balazsradak/Ventilator/manufacturing/blower/CAD/tubing_adapter_gasket.dxf

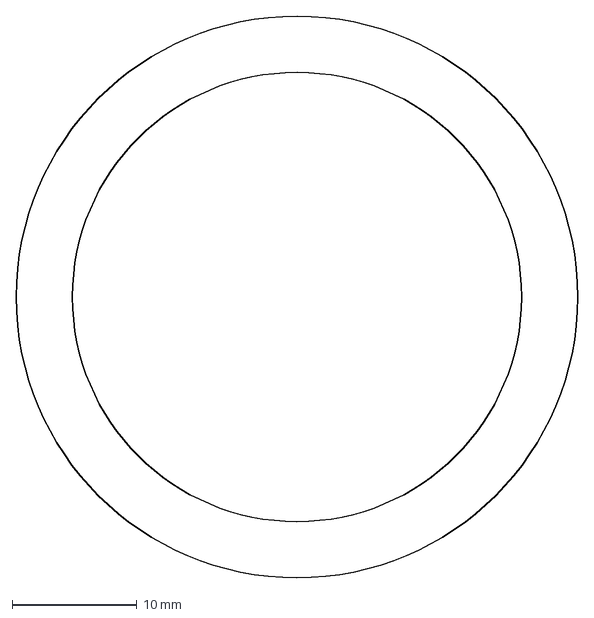
[picture p1: CAD file, 2020-12-17]
manufacturing/blower/CAD/tubing_adapter_gasket.dxf
45.0 x 45.0 mm
