balazsradak/Ventilator/manufacturing/blower/CAD/driver_mounting_plate.dxf

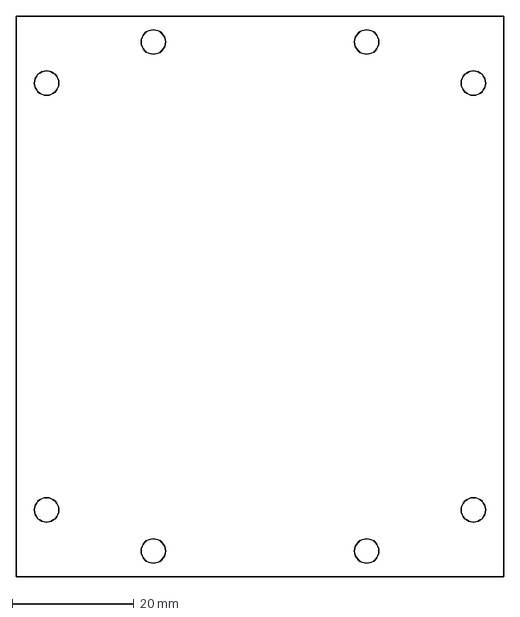
[picture p2: CAD file, 2020-12-15]
manufacturing/blower/CAD/driver_mounting_plate.dxf
80.0 x 92.0 mm
