balazsradak/Ventilator/manufacturing/blower/CAD/blower_holding_plate.dxf

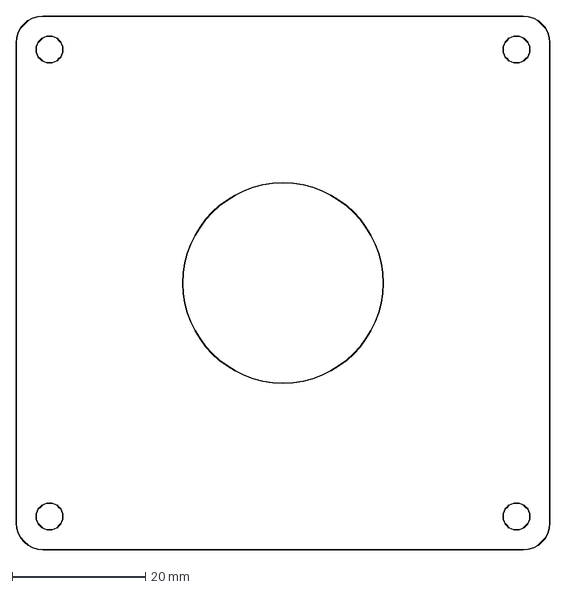
[picture p3: CAD file, 2020-12-15]
manufacturing/blower/CAD/blower_holding_plate.dxf
80.0 x 80.0 mm
