balazsradak/Ventilator/manufacturing/filter_holder/assets/Upper_Acrylic_Face_Plate_ebk v1.dxf

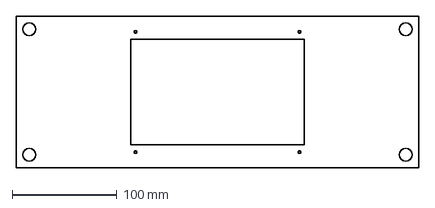
[picture p4: CAD file, 2020-12-18]
manufacturing/filter_holder/assets/Upper_Acrylic_Face_Plate_ebk v1.dxf
385.0 x 145.0 mm
