balazsradak/Ventilator/(list of files, cad)

Other CAD files:
manufacturing/blower/assets/Blower_Driver_Mounting.dxf
manufacturing/filter_holder/assets/Lower_Acrylic_Face_Plate.stl
manufacturing/blower/assets/Blower_gasket1.dxf
manufacturing/filter_holder/assets/Upper_Acrylic_Face_Plate.stl
manufacturing/blower/assets/Blower_Holding_plate.dxf
manufacturing/blower/assets/Blower_gasket2.dxf
manufacturing/blower/assets/Blower_adapter_holding_plate.dxf
manufacturing/blower/CAD/Blower Assembly.iam
manufacturing/blower/CAD/Dummy Pnuematics Tray.ipt
manufacturing/blower/CAD/WS7040-12-X200N [Blower] v1.ipt
manufacturing/blower/CAD/blower_gasket.ipt
manufacturing/blower/CAD/blower_holding_plate.idw
manufacturing/blower/CAD/blower_holding_plate.ipt
manufacturing/blower/CAD/driver_mounting_plate.idw
manufacturing/blower/CAD/driver_mounting_plate.ipt
manufacturing/blower/CAD/tubing_adapter.idw
manufacturing/blower/CAD/tubing_adapter.ipt
manufacturing/blower/CAD/tubing_adapter_gasket.ipt
manufacturing/blower/CAD/tubing_adapter_holding_plate.idw
manufacturing/blower/CAD/tubing_adapter_holding_plate.ipt
manufacturing/filter_holder/assets/Lower_Acrylic_Face_Plate.dxf
manufacturing/filter_holder/assets/Lower_Acrylic_Face_Plate.idw
manufacturing/filter_holder/assets/Lower_Acrylic_Face_Plate.ipt
manufacturing/filter_holder/assets/Upper_Acrylic_Face_Plate.dxf
manufacturing/filter_holder/assets/Upper_Acrylic_Face_Plate.idw
manufacturing/filter_holder/assets/Upper_Acrylic_Face_Plate.ipt
