balazsradak/Ventilator/manufacturing/blower/README.md

# Blower Sub-assembly



The blower/fan provides air pressure to the ventilator's pneumatic circuit. Currently this is only responsible for
delivery of ambient air, independent of the question of oxygen supply. In a full system that includes oxygen supply,
the blower is a subsystem to the overarching gas delivery control system.

Characterization tests for the blower are [here](characterization-tests).

## Basic assembly

This entails the bare essentials for a functional testing setup, such as a [pizza build](../pizza_build).
The pneumatic aspect of the blower assembly includes the blower and a short segment of tubing compatible with blower
outlet diameter. The electrical aspect of the blower assembly encompasses the driver board and wires to interface
with the [PCB](../../pcb).

### Parts

**Note: If you are a member of the RespiraWorks team, review the [part purchasing guidelines][ppg]
BEFORE purchasing any parts.**

[ppg]: ../../manufacturing/purchasing_guidelines.md

| Item | Quantity | Manufacturer  | Part # | Price (USD)  | Sources[*][ppg] | Notes |
| ---- |---:| --- | --- | ---:|:---:|---|
|**A1**| 1 | | WS7040-12-X200N | 65.00 | [A][a1ali] | 12v blower and driver. Make sure to choose with driver when ordering. |
|**A2**| 1 | | WS1208 | 24.00 | [W][a2won] | **optional** blower driver, in case blower above did not come with driver. |
|**A3**| ~50 mm | McMaster-Carr | 5234K57 | 21.50 / 5ft  | [C][a3mcmc] | Soft latex tubing, 5/8" ID, 7/8" OD |
|**A4**| 2 | McMaster-Carr | 9579K72 | 12.21 / 20 | [C][a4mcmc] | Herbie clip J (20.3-23mm) for clamping 7/8"OD tubing |
|**A5**| 2 or 4 | JST | SVH-21T-P1.1 | 0.11 | [K][a5digi] [R][a5rs] | VH crimps, for power connector |
|**A6**| 1 or 2 | TE | 1-1123722-2 | 0.18 | [K][a6digi] [R][a6rs] | VH housing 2 pin, for power connector |

[a1ali]:  https://www.aliexpress.com/item/32980201709.html
[a2won]:  https://wonsmart-motor.en.made-in-china.com/product/hsjxFewOppVg/China-Air-Pump12V-Brushless-Motor-12V-Blower-Fan-Driver.html
[a3mcmc]: https://www.mcmaster.com/5234K57
[a4mcmc]: https://www.mcmaster.com/9579K72
[a5digi]: https://www.digikey.com/short/z44fjr
[a5rs]:   https://export.rsdelivers.com/product/jst/svh-41t-p11/jst-nv-vh-female-crimp-terminal-contact-16awg-svh/7620692
[a6digi]: https://www.digikey.com/short/z44fwj
[a6rs]:   https://export.rsdelivers.com/product/jst/vhr-2n/jst-vhr-female-connector-housing-396mm-pitch-2/8201172

**Please note:** Quantities of items a5+a6 depend on whether you intend to integrate the blower into an enclosed
ventilator assembly as [described below](#enclosed-assembly).

### Tools

| Item | Quantity | Manufacturer  | Part # | Price (USD) | Sources[*][ppg] | Notes |
| ---- |---:| --- | --- | ---:|:---:| ----- |
|**B1**| 1 | Preciva | PR-3254 (PR102001)  | 39.99 | [Z][b1amzn] | Crimping tool for HX and HV connectors |

[b1amzn]:https://www.amazon.com/gp/product/B07R1H3Z8X

**Note: Items a5, a6 and b1 above are duplicated in the [wiring BOM](../../design/electrical-system/wiring.md)**

### Instructions for basic assembly

Attach a short segment of tubing (**A3**) to blower (**A1**) outlet.

Use Herbie clip (**A4**) to secure tubing to blower outlet. Alternatively, you can use a zip-tie.

You will also have to crimp connectors (**A5 + A6**) to the second end of the wiring (using **B1**) that connects the
driver board to the [PCB](../../pcb).

A basic assembly is pictured at the top of this page.

**Please note:** the picture above includes an optional tubing reducer that is specified on the [pizza build](../pizza_build) page.

## Enclosed assembly

The basic assembly needs further modifications to be mounted into an [enclosed ventilator assembly](../enclosed_build).
The pneumatic interface includes gaskets and adapter for tubing that runs to the filtered air inlet on the front panel.
The mechanical aspect of this assembly includes all hold-down and mounting plates for the blower and blower
driver board, and for the above pneumatic interface components. Electrically, the enclosed assembly also requires longer
wiring.

### Parts 2

| Item  | Quantity | Manufacturer  | Part # | Price (USD) | Sources[*][ppg] | Notes |
| ----- |---:| --- | --- | ---:|:---:|---|
|**C1** | 1 | RespiraWorks  | tubing_adapter | 1 (material) | [B][c1rw] | 3D printed from data in link |
|**C2** | ~200cm²  | McMaster-Carr | 8560K357 | 54.68 / 3716cm²  | [C][c2mcmc] | 1/4" (~6mm) thick clear acrylic sheet, to make **C3-C5** below |
|**C3** | 1 | RespiraWorks  | driver_mounting_plate | ~1.1 (material)  | [B][c3rw] | Driver mounting plate cut from acrylic (**C2**) using drawing in link, uses ~75 cm² |
|**C4** | 1 | RespiraWorks  | blower_holding_plate | ~0.9 (material)  | [B][c4rw] | Blower holding plate cut from acrylic (**C2**) using drawing in link, uses ~60 cm² |
|**C5** | 1 | RespiraWorks  | tubing_adapter_holding_plate | ~0.9 (material)  | [B][c5rw] | Tubing adapter holding plate cut from acrylic (**C2**) using drawing in link, uses ~60 cm² |
|**C6** | ~80cm² | McMaster-Carr | 1370N13-1370N131 | 6.75 / 232cm² | [C][c6mcmc] | 1/16" durometer 30 neoprene gasket material, to make items **C7** and **C8** below |
|**C7** | 1 | RespiraWorks  | blower_gasket | ~1.2 (material)  | [B][c7rw] | Blower gasket cut from (**C6**) using drawing in link, uses ~40 cm² |
|**C8** | 1 | RespiraWorks  | tubing_adapter_gasket | ~1.2 (material)  | [B][c8rw] | Tubing adapter Gasket cut from (**C6**) using drawing in link, uses ~40 cm² |
|**C9** | 8 | McMaster-Carr | 93625A150 | 6.04 / 100 | [C][c9mcmc] | M4 nylon insert lock nuts |
|**C10**| 16 | McMaster-Carr | 93475A230 | 1.86 / 100 | [C][c10mcmc] | M4 washers |
|**C11**| 4 | McMaster-Carr | 92000A224 | 9.60 / 100 | [C][c11mcmc] | M4 x 14mm Philips head screws, for blower driver |
|**C12**| 4 | McMaster-Carr | 91290A574 | 15.45 / 10 | [C][c12mcmc] | M4 x 85 mm hex head screws |
|**C13**| 4 | McMaster-Carr | 93657A079 | 1.21 | [C][c13mcmc] | 10mm nylon spacers |
|**C14**| 4 | McMaster-Carr | 91828A231 | 6.45 / 100 | [C][c14mcmc] | M4 nuts (non locking) |
|**C15**| 12 | JST | SXH-001T-P0.6 | 0.10 | [K][c15digi] [R][c15rs] | XH crimps, for control connector |
|**C16**| 2 | JST | XHP-6 | 0.14 | [K][c16digi] [R][c16rs] | XH 6-pin housing, for control connector |
|**C17**| - | CQRobot | CQRJST254-BGB | 9.99 | [Z][c17amzn] | **optional** XH connector kit for 6/7/8 pins, alternative for b15+b16 above |
|**C18**| ~1m | Remington | 16UL1007STRKIT | 29.70 / 25m | [K][c18amzn] | 16 AWG wire, for power cable, ~42cm per wire |
|**C19**| ~3m | Remington | 26UL1007STRKIT10COLOR | 31.60 / 75m | [K][c19amzn] | 26 AWG wire, for control cable, ~42cm per wire  |

[c1rw]:    CAD/tubing_adapter.stl
[c2mcmc]:  https://www.mcmaster.com/8560K357/
[c3rw]:    CAD/driver_mounting_plate.dxf
[c4rw]:    CAD/blower_holding_plate.dxf
[c5rw]:    CAD/tubing_adapter_holding_plate.dxf
[c6mcmc]:  https://www.mcmaster.com/1370N13-1370N131/
[c7rw]:    CAD/blower_gasket.dxf
[c8rw]:    CAD/tubing_adapter_gasket.dxf
[c9mcmc]:  https://www.mcmaster.com/93625A150/
[c10mcmc]: https://www.mcmaster.com/93475A230/
[c11mcmc]: https://www.mcmaster.com/92000A224/
[c12mcmc]: https://www.mcmaster.com/91290A574/
[c13mcmc]: https://www.mcmaster.com/93657A079/
[c14mcmc]: https://www.mcmaster.com/91828A231/
[c15digi]: https://www.digikey.com/short/z44f8d
[c15rs]:   https://export.rsdelivers.com/product/jst/sxh-002t-p06/jst-xh-female-crimp-terminal-contact-26awg-sxh/1755645
[c16digi]: https://www.digikey.com/short/z44ff8
[c16rs]:   https://export.rsdelivers.com/product/jst/xhp-6/jst-xhp-female-connector-housing-25mm-pitch-6-way/8201620
[c17amzn]: https://www.amazon.com/gp/product/B079MJ1RYN
[c18amzn]: https://www.amazon.com/gp/product/B00N51OJJ4
[c19amzn]: https://www.amazon.com/gp/product/B011JC76OA

**NOTE: Items **C15-C19** above are also duplicated in the [wiring BOM](../../design/electrical-system/wiring.md)**

### Tools 2

| Item | Quantity | Manufacturer | Part # | Price (USD)  | Sources[*][ppg] | Notes |
| --- |---:| --- | ---| ---:|:---:|:---|
| **D1** | 1 | Fiskars | 167110-1001 | 5.49 | [A][d1amzn] | Craft knife, for cutting gaskets |
| **D2** | 1 | Black & Decker | BDEJS300C | 24.49 | [A][d2amzn] | Jigsaw, for cutting acrylic |
| **D3** | 1 | Black & Decker | BDEDMT | 29.99 | [A][d3amzn] | Electric hand drill, **drill press preferred if you have one**, for drilling acrylic |
| **D4** | 1 | XLCMSY | EAN: 0742880496381 | 12.99 | [A][d4amzn] | Cobalt metric drill bits, in particular - 4.5mm |
| **D5** | 1 | Porter Cable | PC1014 | 59.59 | [A][d5amzn] | Forstner bits, **preferred for drill press** |
| **D6** | 1 | KATA TOOLS | KTL89020 | 19.99 | [A][d5amzn] | Hole saws, **preferred for hand drill** |

[d1amzn]: https://www.amazon.com/Fiskars-167110-1001-Heavy-Craft-Knife/dp/B001A42CTW
[d2amzn]: https://www.amazon.com/BLACK-DECKER-Jig-Amp-BDEJS300C/dp/B00OJ72L84
[d3amzn]: https://www.amazon.com/BLACK-DECKER-BDEDMT-Matrix-Driver/dp/B0094B9BHE
[d4amzn]: https://www.amazon.com/XLCMSY-Straight-Resistant-Stainless-1-5-6-5mm/dp/B07ZQGXWGL
[d5amzn]: https://www.amazon.com/PORTER-CABLE-PC1014-Forstner-Bit-14-Piece/dp/B004TSZEB4
[d6amzn]: https://www.amazon.com/KATA-19-152mm-Mandrels-Installation-Plywood/dp/B08JCHY2DM

### Custom component manufacture

#### Tubing adapter (C1)

To 3d print this component see the [general 3d printing guidelines](../3d_printing).

| Rendering | STL | Inventor | Engineering Drawing |
|:---:|:---:|:---:|:---|
||[tubing_adapter.stl](CAD/tubing_adapter.stl)|[tubing_adapter.ipt](CAD/tubing_adapter.ipt)|[tubing_adapter.pdf](CAD/tubing_adapter.pdf)

#### Gaskets

Use craft knife (**D1**) to cut these from the gasket material (**C6**).

| | Blower gasket (C7) | Tubing adapter gasket (C8)  |
|----:|:---:|:---:|
| PNG |  |  |
| DXF |[blower_gasket.dxf](CAD/blower_gasket.dxf)|[tubing_adapter_gasket.dxf](CAD/tubing_adapter_gasket.dxf)|

#### Acrylic plates

You will have to cut the following mounting and holding plates from an acrylic sheet (**C2**).

If you have access to an adequately powerful laser cutter, it should be able to perform all perimeter and hole cuts.

Otherwise you will need some combination of tools (**D2-6**) listed in the [Tools 2](#tools-2) section above.

Out of the drill sets, you will need:
- 4.5mm (11/64") drill bit (from **D4**) for fastener holes (make them slightly larger than specified in drawings)
- 30mm (1-1/4") Forstner bit or hole cutter (from either **D5** or **D6**)
- 37mm (1-1/2") Forstner bit or hole cutter (from either **D5** or **D6**)

You might also want to use some 200 grit sandpaper to clean up the edges of the pieces you cut and drill.

| | Driver mounting plate (C3) | Blower holding plate (C4) | Tubing adapter holding plate (C5) |
|:-----:|:---:|:---:|:---:|
| Drawings |<br>[Driver Mounting Plate](CAD/driver_mounting_plate.pdf)|<br>[Blower Holding Plate](CAD/blower_holding_plate.pdf)|<br>[Tubing Adapter Holding Plate](CAD/tubing_adapter_holding_plate.pdf)|
| DXF |[driver_mounting_plate.dxf](CAD/driver_mounting_plate.dxf)|[blower_holding_plate.dxf](CAD/blower_holding_plate.dxf)|[tubing_adapter_holding_plate.dxf](CAD/tubing_adapter_holding_plate.dxf)|
| Inventor | [driver_mounting_plate.ipt](CAD/driver_mounting_plate.ipt)|[blower_holding_plate.ipt](CAD/blower_holding_plate.ipt)| [tubing adapter_holding_plate.ipt](CAD/tubing_adapter_holding_plate.ipt)|

You can use one of these plates as a template to drill the appropriate holes in the main acrylic plate and the metal
frame that supports it.

The above manufactured components (excluding gaskets) should appear as follows:



### Assembly instructions

#### Mount the blower driver

Use the following hardware:
* 4x M4 lock nuts (**C9**)
* 4x M4 washers (**C10**)
* 4x M4 14mm screws (**C11**)

Mount the blower driver (**A2**) to the Driver mounting plate (**C3**). It is advisable to run the screws from the
bottom up, because the screw heads may be too wide to fit next to the circuit board.



#### Make blower sandwich

| | |
|:---:|:---:|
|Take the mounted blower driver from step above, and run four 85mm screws (**C12**) with m4 washers (**C10**) downwards. | Flip this assembly upside down. Put four spacers (**C13**) on the screws. Run the wiring of blower (**A1**) through hole in blower holding plate (**C4**)|
| |  |

| | |
|:---:|:---:|
| Slide the blower holding plate over the screws so that wiring comes out through the space between the two plates, with blower on top. Place blower gasket (**C7**) on main enclosed ventilator assembly. | Carefully to not lose the screws, flip the blower sandwich and install it onto the main assembly. Fasten with m4 washers (**C10**) and regular non-locking nuts (**C14**).|
| |  |

Tighten carefully one nut at a time, ensuring a tight gasket seal. Do not over-tighten. If you see the acrylic holding plate begin to bend, relax the fasteners somewhat.

#### Install tubing adapter

You will likely need some sort of small clamps for this step, to ensure that components stay in place while you fasten them.

* Make sure the air filter assembly plate is (temporarily) fitted to the main ventilator assembly.
* Flip the ventilator assembly face-down, so that the bottom of the main assembly plate faces you vertically.
* Insert tubing adapter (**C1**) through the tubing adapter holding plate (**C5**) and place this assembly on the bottom side of the main mounting plate.
* Now insert the tubing adapter gasket (**C8**) in the gap, adjust its position to be centered on the blower inlet and apply pressure with the tubing adapter to hold it in place.
* Turn the tubing adapter so that the tubing barb faces the general direction of the air filter assembly that it will connect to.
* Temporarily clamp the entire blower assembly in place.
* Fasten with m4 washers (**C10**) and lock nuts (**C9**).

| | |
|:---:|:---:|
| |  |

#### Manufacture extended wiring

The power and signal cables that come included with the blower are too short to reach the PCB, so new ones must be
manufactured using **A5, A6, and C15-C19**. Please follow the old cables included with blower as examples as well as
any advice on the [wiring assembly page](../../design/electrical-system/wiring.md).

The new cables should each be about 42cm in length.

**#TODO:** Some sort of shrink tubing should also be used



## Price estimate

**Basic assembly:**

65 (A1) + 0.70 (A3) + 1.20 (A4) + 0.22 (A5) + 0.18 (A6) = 67.30 USD

**Complete assembly for enclosure:**

67.30 (basic assembly) + 1 (C1) + 3 (C3-5) + 2.5 (C7-8) + 0.48 (C9) + 0.3 (C10) + 0.4 (C11) + 6.18 (C12) + 4.84 (C13)  +
0.26 (C14) + 1.2 (C15) + 0.28 (C16) + 1.2 (C18) + 1.3 (C19) + 0.22 (A5) + 0.18 (A6) = 90.64 USD
