balazsradak/Ventilator/(commit log)

2020-10-25 Updated the notes and script for streaming to YouTube. Updated the info on Relay.
2020-11-15 progress with UART
2020-12-11 Added .ipt of tubing adapter;
    Added tubing adapter link to ReadMe, added blower holding plate.ipt
    readme actually updated this time!
    Added tubing adapter drawing; updates #924
    [blower_holding_plate.ipt, tubing_adapter.idw, tubing_adapter.ipt]
2020-12-15 Added tubing adapter drawing pdf to readme, reformatted tubing adapter section to remove solidworks files. Added blower holdign plate drawings and inventor files, added to readme; updates #924
    [Blower_Driver_Mounting.dxf, Blower_Holding_plate.dxf, Blower_adapter_holding_plate.dxf, Blower_gasket1.dxf, Blower_gasket2.dxf, blower_holding_plate.dxf, tubing_adapter.sldprt]
2020-12-15 Added tubing adapter holding plate .ipt, .idw, and pdf to readme, replaced image with drawing; updates #924
    [blower_holding_plate.idw, blower_holding_plate.ipt, tubing_adapter_holding_plate.idw, tubing_adapter_holding_plate.ipt]
2020-12-15 Created files for driver mounting plate
    [driver_mounting_plate.dxf, driver_mounting_plate.idw, driver_mounting_plate.ipt]
2020-12-16 Added tubing adapter holding plate idw and ipt
2020-12-16 Added blower .ipt, began work on lower assembly model. Updates #924
    [Blower Assembly.iam, WS7040-12-X200N [Blower] v1.ipt]
2020-12-17 Revised tubing adapter ID to match blower inlet, added gaskets, modified tubing adapter gasket to fit around tubing adapter location fit, worked on assembly model. Updates #924
    [Blower Assembly.iam, Dummy Pnuematics Tray.ipt, blower_gasket.ipt, tubing_adapter.idw, tubing_adapter.ipt, tubing_adapter_gasket.dxf, tubing_adapter_gasket.ipt]
2020-12-18 Upper and lower acrylic face plate related part file, drawing, PDF and DXF added
    [Lower_Acrylic_Face_Plate.dxf, Lower_Acrylic_Face_Plate.idw, Lower_Acrylic_Face_Plate_ebk v3.ipt, Upper_Acrylic_Face_Plate_ebk v1.dxf, Upper_Acrylic_Face_Plate_ebk v1.idw, Upper_Acrylic_Face_Plate_ebk v1.ipt]
2020-12-18 upper and lower face plate redesigned and related files added
2021-01-19 Changed corner mounting holes of upper and lower face plates to allow for M4 nuts, same as pneumatic tray mounting to enclsoure tray. Added .stl files for both as well; updates #938; updates #937
    [Lower_Acrylic_Face_Plate.dxf, Lower_Acrylic_Face_Plate.idw, Lower_Acrylic_Face_Plate.ipt, Lower_Acrylic_Face_Plate.stl, Lower_Acrylic_Face_Plate_ebk v3.ipt, Upper_Acrylic_Face_Plate.dxf, Upper_Acrylic_Face_Plate.idw, Upper_Acrylic_Face_Plate.ipt]
